shaheerrrrr/next2026/sol_screen3.png

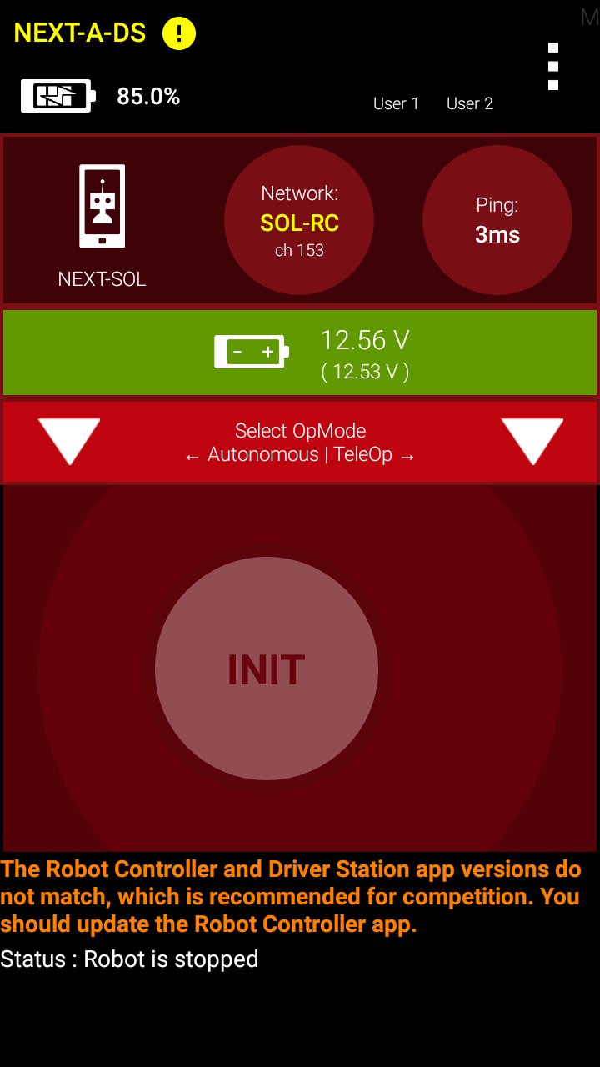
sol_screen3.png
