shaheerrrrr/next2026/sol/sol.ino

#include <SPI.h>
#include <RH_RF95.h>
#include <HID.h>

#define ROBOT_ID 3
#define ROBOT_NAME "Sol"
#define ROBOT_ALL 255

#define RFM95_CS 8
#define RFM95_RST 4
#define RFM95_INT 7

#define RF95_FREQ 915.0
#define FRAME_LEN 21
#define PROTOCOL_VERSION 3
#define LED 13

#define BTN_CROSS      0x0001
#define BTN_SQUARE     0x0004
#define BTN_OPTIONS    0x0010
#define BTN_DPAD_UP    0x0080
#define BTN_DPAD_DOWN  0x0100
#define BTN_DPAD_LEFT  0x0200
#define BTN_DPAD_RIGHT 0x0400

#define STALE_MS 250
#define HID_SEND_INTERVAL_MS 20
#define HID_REPORT_ID 1
#define HAT_NEUTRAL 8

RH_RF95 rf95(RFM95_CS, RFM95_INT);

static const uint8_t desc_hid_report[] PROGMEM = {
  0x05, 0x01,
  0x09, 0x05,
  0xA1, 0x01,
  0x85, HID_REPORT_ID,

  0x05, 0x09,
  0x19, 0x01,
  0x29, 0x10,
  0x15, 0x00,
  0x25, 0x01,
  0x75, 0x01,
  0x95, 0x10,
  0x81, 0x02,

  0x05, 0x01,
  0x09, 0x30,
  0x09, 0x31,
  0x09, 0x32,
  0x09, 0x35,
  0x15, 0x81,
  0x25, 0x7F,
  0x75, 0x08,
  0x95, 0x04,
  0x81, 0x02,

  0x05, 0x02,
  0x09, 0xC5,
  0x09, 0xC4,
  0x15, 0x00,
  0x26, 0xFF, 0x00,
  0x75, 0x08,
  0x95, 0x02,
  0x81, 0x02,

  0x05, 0x01,
  0x09, 0x39,
  0x15, 0x00,
  0x25, 0x07,
  0x35, 0x00,
  0x46, 0x3B, 0x01,
  0x65, 0x14,
  0x75, 0x04,
  0x95, 0x01,
  0x81, 0x42,
  0x75, 0x04,
  0x95, 0x01,
  0x81, 0x03,

  0xC0
};

typedef struct __attribute__((packed)) {
  uint16_t buttons;
  int8_t x;
  int8_t y;
  int8_t z;
  int8_t rz;
  uint8_t brake;
  uint8_t accelerator;
  uint8_t hat;
} lora_gamepad_report_t;

class SolGamepadHID {
 public:
  SolGamepadHID() : descriptorNode(desc_hid_report, sizeof(desc_hid_report)) {
    HID().AppendDescriptor(&descriptorNode);
  }

  bool sendReport(const lora_gamepad_report_t &report) {
    return HID().SendReport(HID_REPORT_ID, &report, sizeof(report)) >= 0;
  }

 private:
  HIDSubDescriptor descriptorNode;
};

SolGamepadHID usb_hid;
lora_gamepad_report_t gp;

unsigned long lastFrameMs = 0;
unsigned long lastHidSendMs = 0;

int16_t latestLx = 0;
int16_t latestLy = 0;
int16_t latestRx = 0;
int16_t latestRy = 0;
uint16_t latestRt = 0;
uint16_t latestButtons = 0;

uint8_t xorChecksum(const uint8_t *data, uint8_t len) {
  uint8_t c = 0;
  for (uint8_t i = 0; i < len; i++) {
    c ^= data[i];
  }
  return c;
}

bool frameIsValid(const uint8_t *buf, uint8_t len) {
  if (len != FRAME_LEN) return false;
  if (buf[0] != 0xA5 || buf[1] != 0x5A) return false;
  if (buf[2] != PROTOCOL_VERSION) return false;

  uint8_t expected = xorChecksum(buf + 2, FRAME_LEN - 3);
  return expected == buf[FRAME_LEN - 1];
}

bool frameIsForThisRobot(const uint8_t *buf) {
  uint8_t targetRobot = buf[3];
  return targetRobot == ROBOT_ID || targetRobot == ROBOT_ALL;
}

uint16_t readU16(const uint8_t *buf, uint8_t offset) {
  return (uint16_t)buf[offset] | ((uint16_t)buf[offset + 1] << 8);
}

int16_t readI16(const uint8_t *buf, uint8_t offset) {
  return (int16_t)readU16(buf, offset);
}

int8_t stickToHid(int16_t value) {
  value = constrain(value, -1000, 1000);
  return (int8_t)map(value, -1000, 1000, -127, 127);
}

uint8_t triggerToHid(uint16_t value) {
  value = constrain(value, 0, 1000);
  return (uint8_t)map(value, 0, 1000, 0, 255);
}

uint8_t dpadToHat(uint16_t buttons) {
  bool up = buttons & BTN_DPAD_UP;
  bool down = buttons & BTN_DPAD_DOWN;
  bool left = buttons & BTN_DPAD_LEFT;
  bool right = buttons & BTN_DPAD_RIGHT;

  if (up && right) return 1;
  if (right && down) return 3;
  if (down && left) return 5;
  if (left && up) return 7;
  if (up) return 0;
  if (right) return 2;
  if (down) return 4;
  if (left) return 6;
  return HAT_NEUTRAL;
}

void resetRadio() {
  digitalWrite(RFM95_RST, LOW);
  delay(10);
  digitalWrite(RFM95_RST, HIGH);
  delay(10);
}

void neutralizeControls() {
  latestLx = 0;
  latestLy = 0;
  latestRx = 0;
  latestRy = 0;
  latestRt = 0;
  latestButtons = 0;
}

void updateGamepadReport() {
  memset(&gp, 0, sizeof(gp));

  gp.x = stickToHid(latestLx);
  gp.y = stickToHid(latestLy);
  gp.z = stickToHid(latestRx);
  gp.rz = stickToHid(latestRy);
  gp.brake = 0;
  gp.accelerator = triggerToHid(latestRt);
  gp.hat = dpadToHat(latestButtons);

  if (latestButtons & BTN_CROSS) {
    gp.buttons |= (1UL << 0);
  }
  if (latestButtons & BTN_SQUARE) {
    gp.buttons |= (1UL << 3);
  }
  if (latestButtons & BTN_OPTIONS) {
    gp.buttons |= (1UL << 11);
  }
}

void printReceivedFrame(uint16_t seq, uint16_t buttons, int rssi) {
  if (!Serial) return;

  Serial.print(ROBOT_NAME);
  Serial.print(" seq=");
  Serial.print(seq);
  Serial.print(" lx=");
  Serial.print(latestLx);
  Serial.print(" ly=");
  Serial.print(latestLy);
  Serial.print(" rx=");
  Serial.print(latestRx);
  Serial.print(" ry=");
  Serial.print(latestRy);
  Serial.print(" rt=");
  Serial.print(latestRt);
  Serial.print(" buttons=0x");
  Serial.print(buttons, HEX);
  Serial.print(" hat=");
  Serial.print(gp.hat);
  Serial.print(" hid_buttons=0x");
  Serial.print(gp.buttons, HEX);
  Serial.print(" rssi=");
  Serial.println(rssi);
}

void setup() {
  Serial.begin(115200);
  delay(100);

  pinMode(LED, OUTPUT);
  pinMode(RFM95_RST, OUTPUT);
  digitalWrite(RFM95_RST, HIGH);

  HID().begin();

  resetRadio();

  if (!rf95.init()) {
    while (1) {
      digitalWrite(LED, !digitalRead(LED));
      delay(100);
    }
  }

  if (!rf95.setFrequency(RF95_FREQ)) {
    while (1) {
      digitalWrite(LED, !digitalRead(LED));
      delay(250);
    }
  }

  rf95.setTxPower(20, false);
  neutralizeControls();
}

void loop() {
  if (rf95.available()) {
    uint8_t buf[RH_RF95_MAX_MESSAGE_LEN];
    uint8_t len = sizeof(buf);

    if (rf95.recv(buf, &len) && frameIsValid(buf, len)) {
      if (frameIsForThisRobot(buf)) {
        uint16_t seq = readU16(buf, 4);

        latestButtons = readU16(buf, 6);
        latestLx = readI16(buf, 8);
        latestLy = readI16(buf, 10);
        latestRx = readI16(buf, 12);
        latestRy = readI16(buf, 14);
        latestRt = readU16(buf, 18);

        lastFrameMs = millis();
        digitalWrite(LED, HIGH);

        updateGamepadReport();
        printReceivedFrame(seq, latestButtons, rf95.lastRssi());
      } else {
        neutralizeControls();
        lastFrameMs = 0;
        digitalWrite(LED, LOW);
      }
    }
  }

  if (lastFrameMs == 0 || millis() - lastFrameMs > STALE_MS) {
    neutralizeControls();
    digitalWrite(LED, LOW);
  }

  if (millis() - lastHidSendMs >= HID_SEND_INTERVAL_MS) {
    updateGamepadReport();
    usb_hid.sendReport(gp);
    lastHidSendMs = millis();
  }
}
