shaheerrrrr/next2026/(commit log)

2026-06-27 Import ftc-lora project
    [app_settings.xml]
2026-07-13 tele-op switching across robots
2026-07-13 driver station updates
2026-07-14 pico integration
2026-07-29 init commit
    [app_settings.xml]
2026-08-06 added open driver-station app functionality
2026-08-06 added fable driver station launch support
